taofuuu/air-PIN-gesture-lock/hardware/measurements/gy521_thickness_1.5mm.jpg

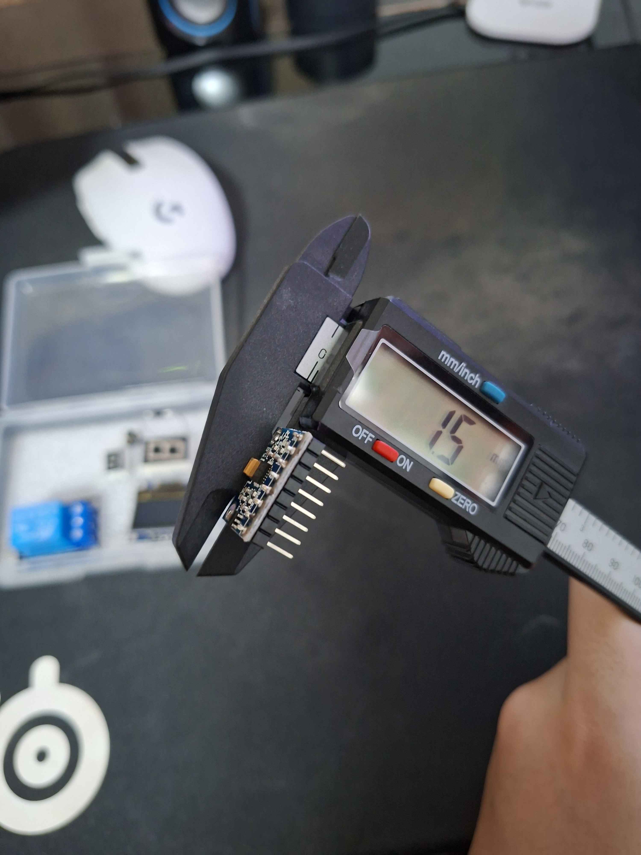
hardware/measurements/gy521_thickness_1.5mm.jpg
