taofuuu/air-PIN-gesture-lock/hardware/measurements/gy521_board-top-to-pin-tips_11.1mm.jpg

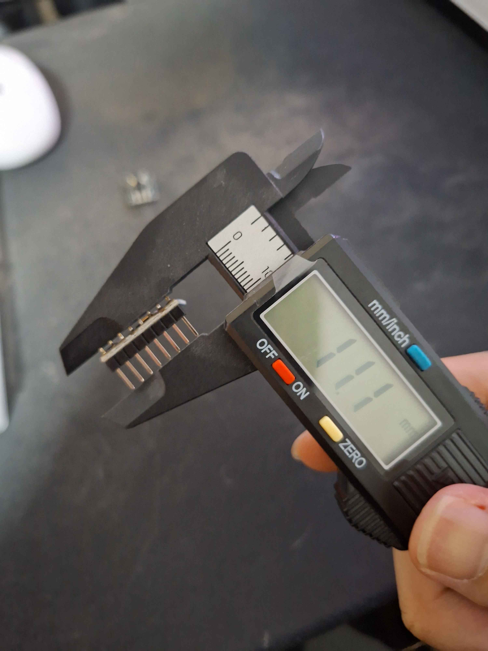
hardware/measurements/gy521_board-top-to-pin-tips_11.1mm.jpg
