taofuuu/air-PIN-gesture-lock/STRUCTURE.md

# Repo structure

Three people, three parts. Each part builds and tests on its own and talks to the others
only through the interfaces at the bottom of this file. Change an interface only after
all three agree.

| Part | Owner |
|---|---|
| ML gesture model | taofuuu |
| PIN mapping | 1999-Chin |
| ESP32 + web IoT dashboard | pedigree-pp |

## Layout

```
air-PIN-gesture-lock/
├── README.md                 overview, wiring, how to build and flash
├── STRUCTURE.md              this file
├── GLOSSARY.md               the words we use for the domain
├── CLAUDE.md                 where AI agents find the issue tracker and these docs
├── docs/adr/                 decisions that are hard to undo, and why
├── docs/agents/              issue tracker, triage labels and domain docs for AI agents
├── hardware/
│   ├── wand.scad             3D-printed wand handle
│   ├── stl/                  print-ready parts: wand_* from wand.scad, nucleo_* from CAD
│   ├── measurements/         photos of the module sizes the wand is fitted to
│   └── wiring.svg            how the sensor and button connect to the Nucleo
├── firmware/
│   ├── stm32/                STM32CubeIDE project, NUCLEO-F411RE          shared
│   │   ├── *.ioc             CubeMX pins and peripherals                 shared
│   │   ├── test/             gesture.c on a PC, with a fake network      ML
│   │   └── Core/
│   │       ├── AI/           network code generated from ml/model/       ML
│   │       ├── Inc/          one header per module = the interfaces below
│   │       └── Src/
│   │           ├── main.c    init, button, relay, calls the modules      shared
│   │           ├── imu.c     MPU-6050 driver                             shared
│   │           ├── button.c  KY-004: hold = gesture, double tap = clear  shared
│   │           ├── gesture.c runs the trained model on a recording       ML
│   │           ├── pin.c     gesture sequence -> PIN check               PIN mapping
│   │           ├── link.c    UART messages to and from the ESP32         ESP32
│   │           └── tool_*.c  bench firmware, one per build configuration (tool.h)
│   └── esp32/                ESP32 project: Wi-Fi, web server            ESP32
│       └── data/             dashboard HTML/CSS/JS served by the ESP32   ESP32
└── ml/                       training on the PC                          ML
    ├── collect.py            records labelled gestures from the Nucleo's USB serial
    ├── dataset.py            loads ml/data/ as raw recordings for training
    ├── test_pipeline.py      python -m unittest discover ml
    ├── requirements.txt      pip install -r ml/requirements.txt
    ├── train.py              trains, evaluates and exports the model
    ├── data/                 one folder per gesture, one CSV per recording;
    │                         folders starting with _ are for evaluation only
    └── model/                exported model that gesture.c is generated from
```

The model runs on the STM32 because the sensor is wired there. Code generated from
`ml/model/` (X-CUBE-AI) goes into `firmware/stm32/Core/AI/` and is
regenerated, never edited by hand.

## Interfaces

**1. IMU to ML** (`imu.h`)

```c
typedef struct { int16_t ax, ay, az, gx, gy, gz; } imu_sample_t;  // raw MPU-6050 counts
```

Sample rate and full-scale ranges are fixed in `imu.c`. Training data must be recorded with
the same settings, so changing them means re-recording.

**2. ML to PIN mapping** (`gesture.h`)

```c
typedef enum { GESTURE_UP, GESTURE_DOWN, GESTURE_LEFT, GESTURE_RIGHT, GESTURE_COUNT } gesture_t;
int gesture_classify(const imu_sample_t *samples, size_t n);  // gesture_t, or -1 if unsure
```

One button hold = one gesture: recording starts when the button is pressed and stops when it
is released. That saves the model from having to find where one gesture ends and the next begins.

A gesture ID is a plain int: PIN mapping and the dashboard store and compare it, and never assume
how many gestures there are or which ID is which. `-1` means unsure and every caller handles it.
These two rules let the model be swapped without touching the other parts
([ADR 0001](docs/adr/0001-classifier-first-embedding-later.md)).

**3. PIN mapping to main** (`pin.h`)

```c
typedef enum { PIN_INCOMPLETE, PIN_OK, PIN_WRONG } pin_result_t;
void pin_reset(void);
pin_result_t pin_add(int gesture);  // main energises the relay on PIN_OK
```

A `-1` from `gesture_classify()` is never stored in a PIN and never fills a slot; on entry it is
neither a digit nor a wrong digit, and the user is asked to repeat
([ADR 0002](docs/adr/0002-unsure-gestures-are-never-pin-input.md)).

**4. STM32 to ESP32** (`link.h`, UART 115200 8N1, one text line per message)

```
STM32 -> ESP32:  GESTURE <id>    UNLOCK OK    UNLOCK FAIL
ESP32 -> STM32:  OPEN            (remote unlock from the dashboard)
```

USART2 is the ST-LINK USB serial and stays free for `ml/collect.py` and debug prints, so the
ESP32 uses another UART. Both boards are 3.3 V logic; connect TX to RX, RX to TX and GND.

## Working rules

- Work on a short branch from `main`, named after the change, and merge it through a pull
  request. Delete the branch once it is merged.
- Everything lives on `main`. Firmware for testing one part on its own is a `tool_*.c` file with
  its own build configuration (see `tool.h`), never a branch: Debug and Release build the lock,
  Collect feeds `ml/collect.py`, GestureTest times the model, HwTest opens the relay on a click.
- Edit only your own files. Shared files (`main.c`, `imu.c`, `*.ioc`, headers in `Inc/`)
  change in small PRs that the others review.
- In CubeMX-generated files, write code only between `/* USER CODE BEGIN */` and
  `/* USER CODE END */`; regenerating wipes everything else.
- Test without the others:
  - ML: train and evaluate on the PC from `ml/data/`.
  - Firmware logic: `firmware/stm32/test/*.c` run on a PC with gcc; the command is at the top
    of each file.
  - PIN mapping: feed `pin_add()` fake gesture ids.
  - ESP32: type the line protocol into a USB-serial terminal instead of a real STM32.
