taofuuu/air-PIN-gesture-lock/hardware/stl/nucleo_f411re_wand_main_box.stl

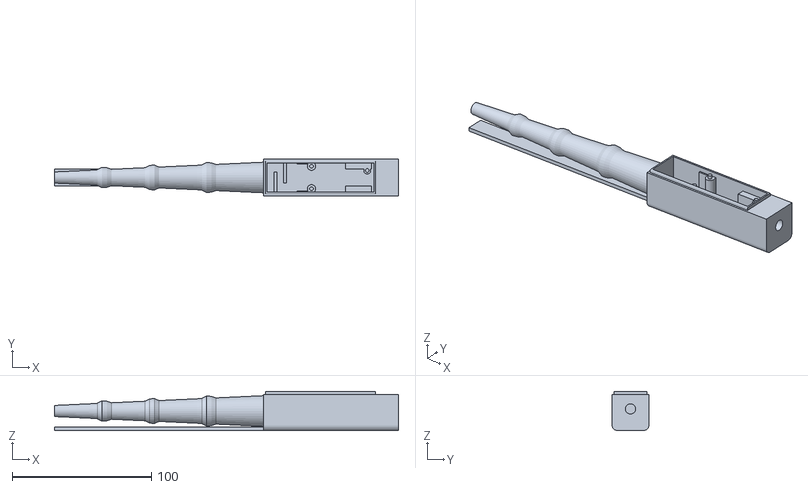
[picture p3: CAD file, 2026-11-12]
hardware/stl/nucleo_f411re_wand_main_box.stl
246.7 x 26.6 x 28.0
