taofuuu/air-PIN-gesture-lock/hardware/stl/nucleo_f411re_holder.stl

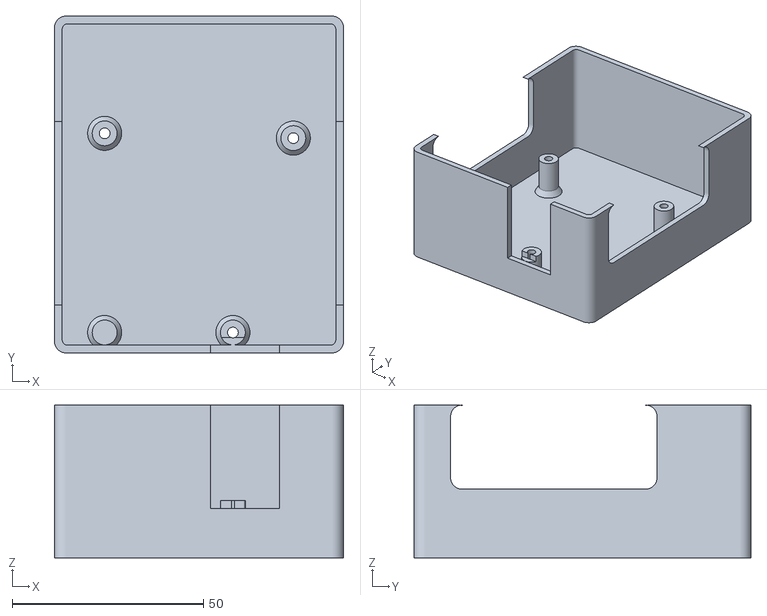
[picture p4: CAD file, 2026-11-12]
hardware/stl/nucleo_f411re_holder.stl
75.6 x 88.1 x 40.0
