taofuuu/air-PIN-gesture-lock/hardware/stl/wand_base.stl

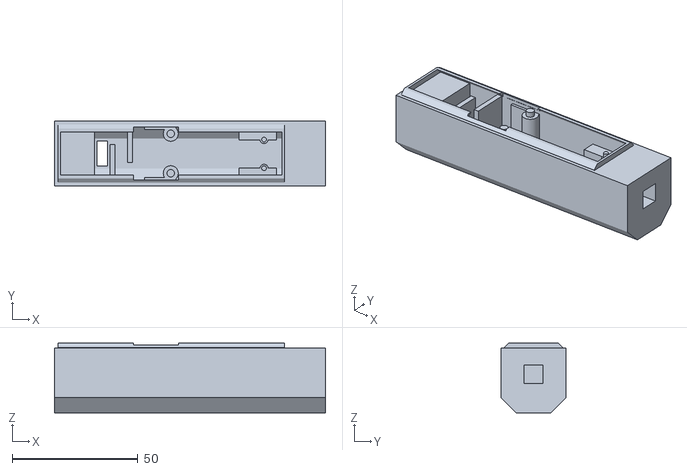
[picture p5: CAD file, 2026-10-31]
hardware/stl/wand_base.stl
107.8 x 26.0 x 27.7
