taofuuu/air-PIN-gesture-lock/hardware/stl/wand_plate.stl

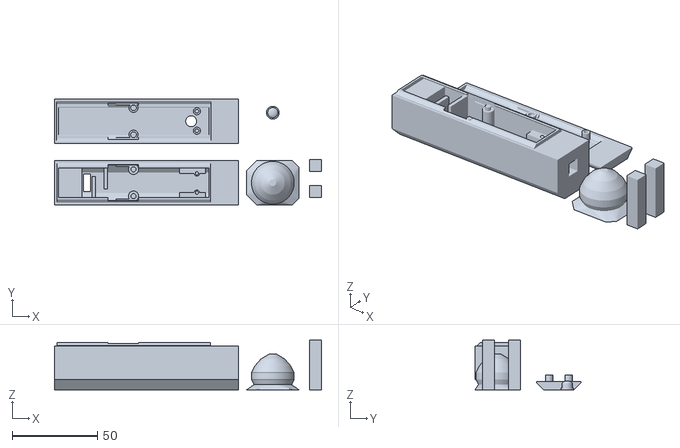
[picture p6: CAD file, 2026-10-31]
hardware/stl/wand_plate.stl
156.3 x 62.0 x 29.0
