taofuuu/air-PIN-gesture-lock/hardware/stl/wand_lid.stl

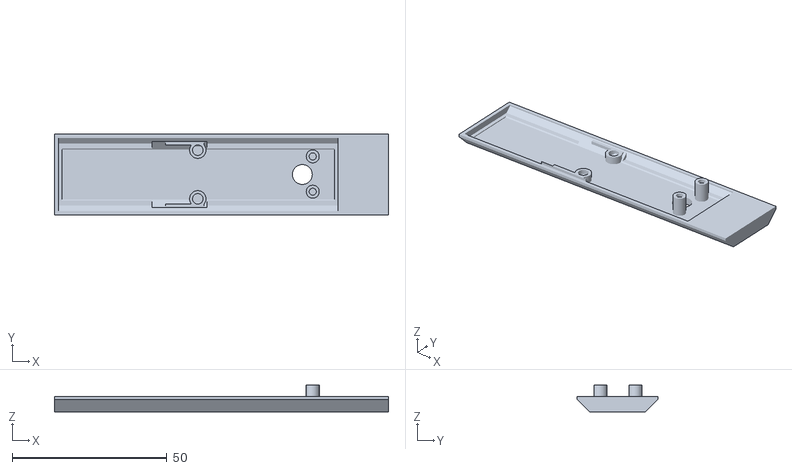
[picture p7: CAD file, 2026-10-31]
hardware/stl/wand_lid.stl
107.8 x 26.0 x 8.65
