taofuuu/air-PIN-gesture-lock/hardware/stl/wand_shaft.stl

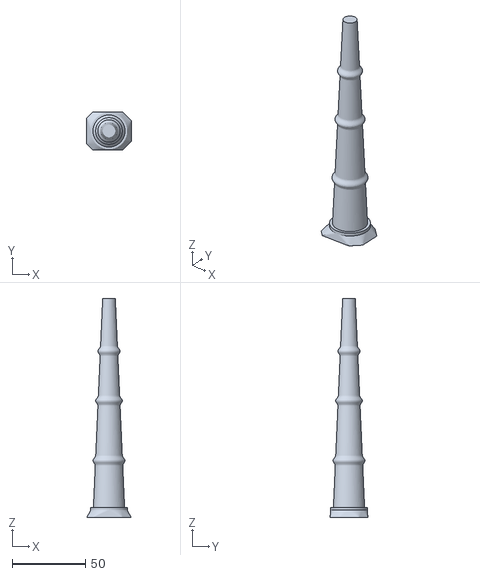
[picture p8: CAD file, 2026-10-30]
hardware/stl/wand_shaft.stl
30.6 x 26.0 x 150.0
