taofuuu/air-PIN-gesture-lock/hardware/stl/wand_cap.stl

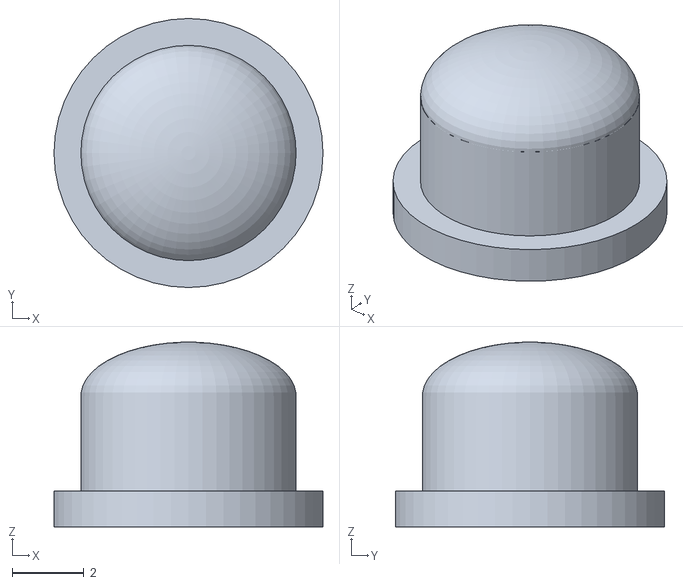
[picture p9: CAD file, 2026-10-30]
hardware/stl/wand_cap.stl
7.50 x 7.50 x 5.15
