taofuuu/air-PIN-gesture-lock/hardware/stl/wand_pommel.stl

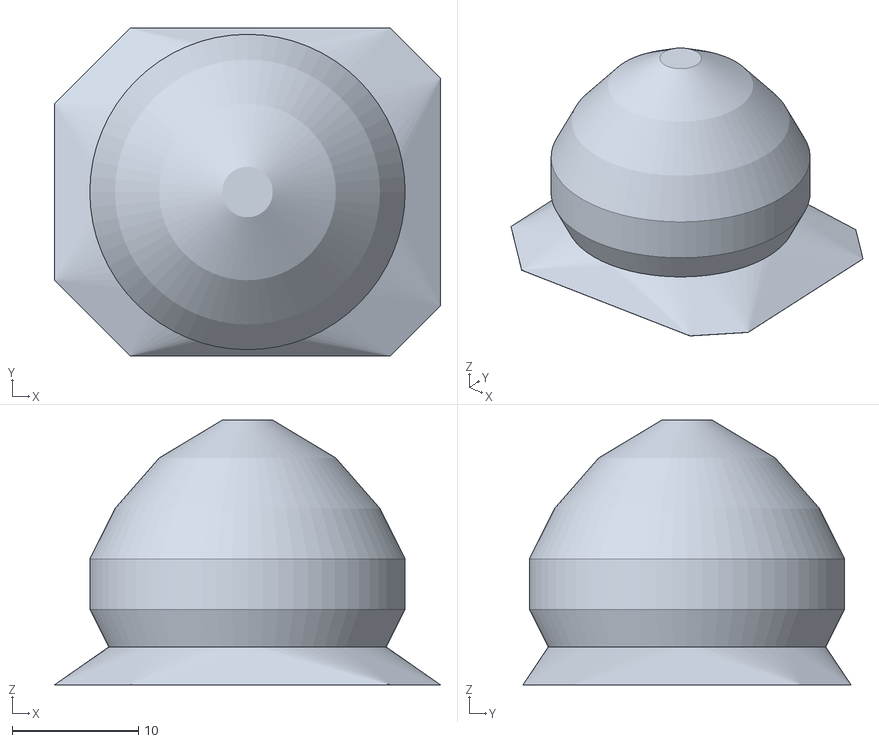
[picture p10: CAD file, 2026-10-30]
hardware/stl/wand_pommel.stl
30.6 x 26.0 x 21.0
