taofuuu/air-PIN-gesture-lock/hardware/stl/wand_pin.stl

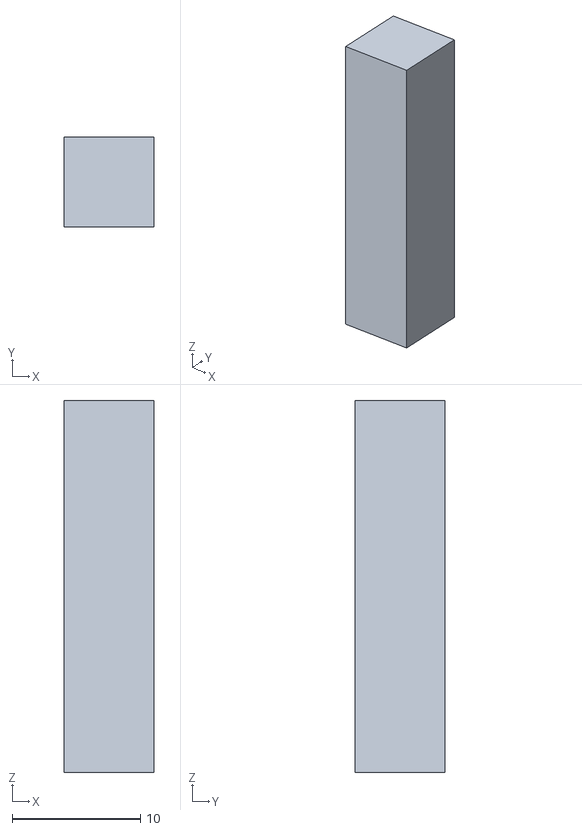
[picture p11: CAD file, 2026-10-30]
hardware/stl/wand_pin.stl
7.00 x 7.00 x 29.0
