taofuuu/air-PIN-gesture-lock/hardware/measurements/ky004_solder-bumps-to-plunger-tip_7.8mm.jpg

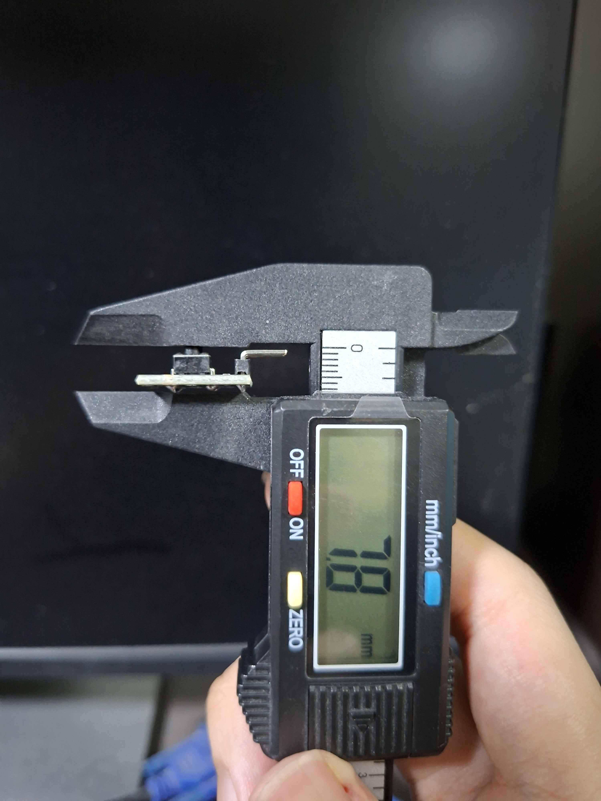
hardware/measurements/ky004_solder-bumps-to-plunger-tip_7.8mm.jpg
