taofuuu/air-PIN-gesture-lock/hardware/measurements/gy521_board-top-to-header-strip-bottom_3.8mm.jpg

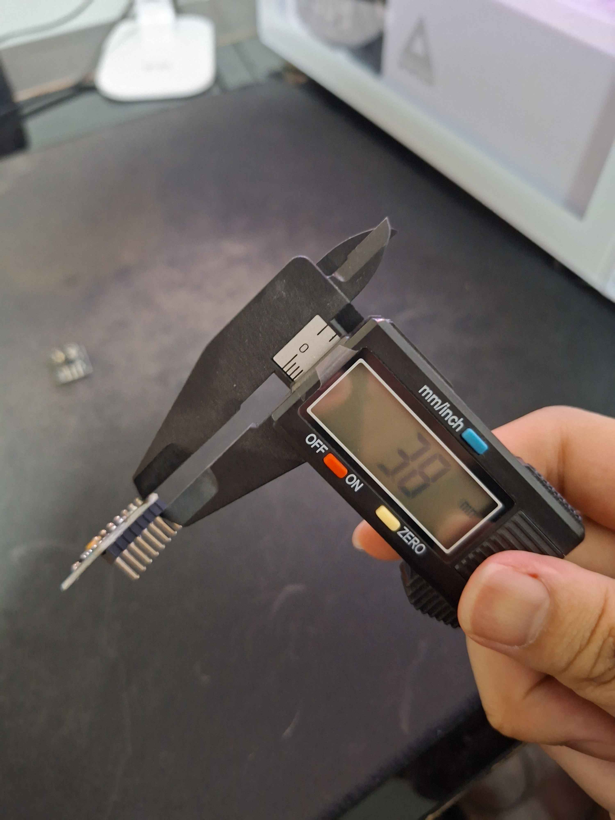
hardware/measurements/gy521_board-top-to-header-strip-bottom_3.8mm.jpg
