taofuuu/air-PIN-gesture-lock/hardware/measurements/gy521_hole-diameter_3.3mm.jpg

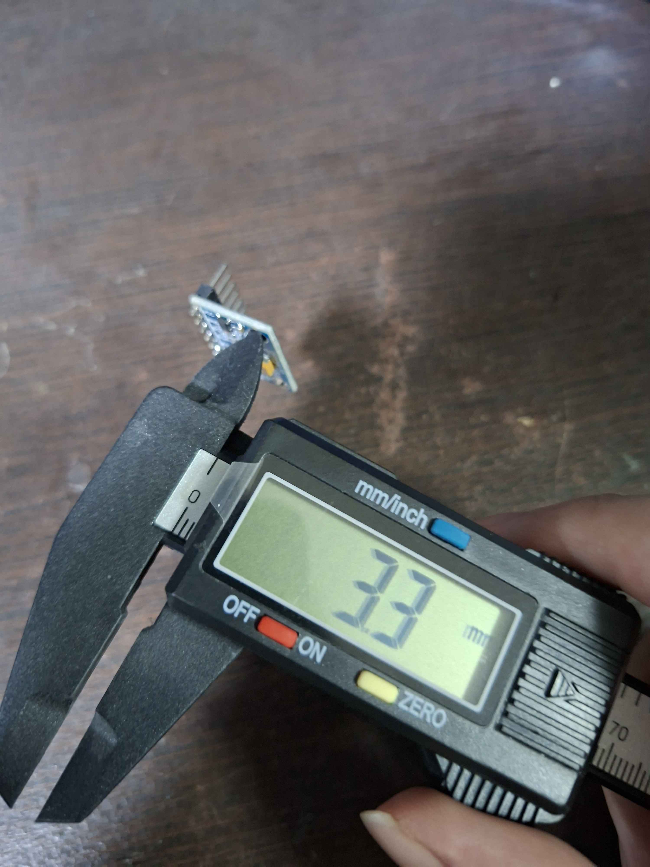
hardware/measurements/gy521_hole-diameter_3.3mm.jpg
