taofuuu/air-PIN-gesture-lock/hardware/measurements/gy521_hole-gap-front-edge_0.4mm.jpg

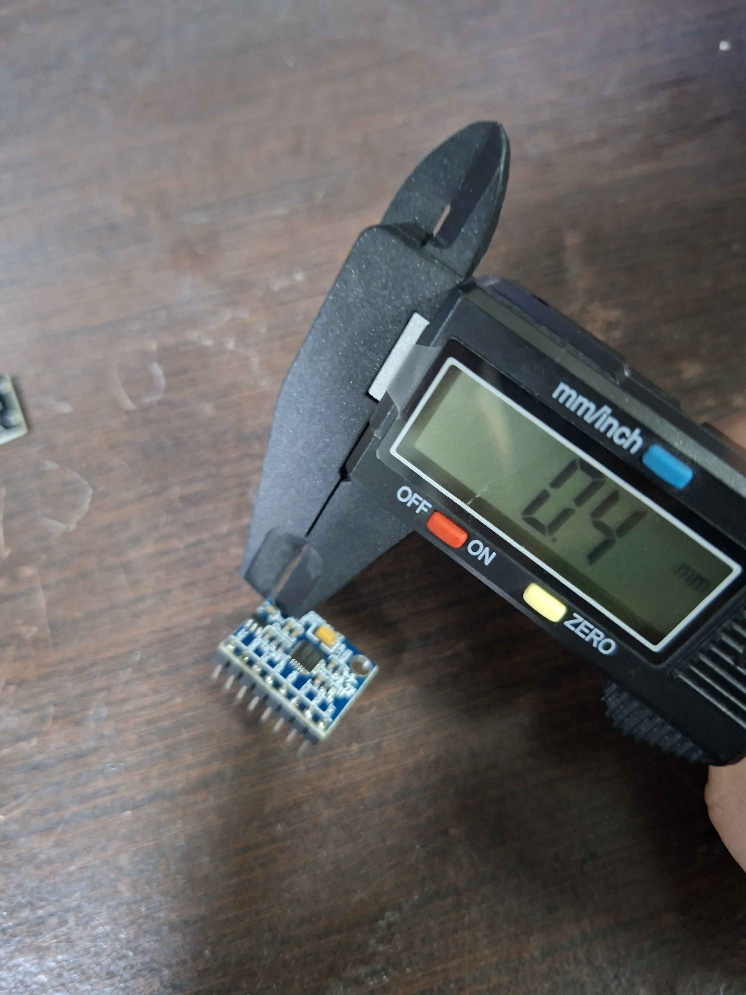
hardware/measurements/gy521_hole-gap-front-edge_0.4mm.jpg
