taofuuu/air-PIN-gesture-lock/hardware/measurements/gy521_hole-gap-side-edge_0.8mm.jpg

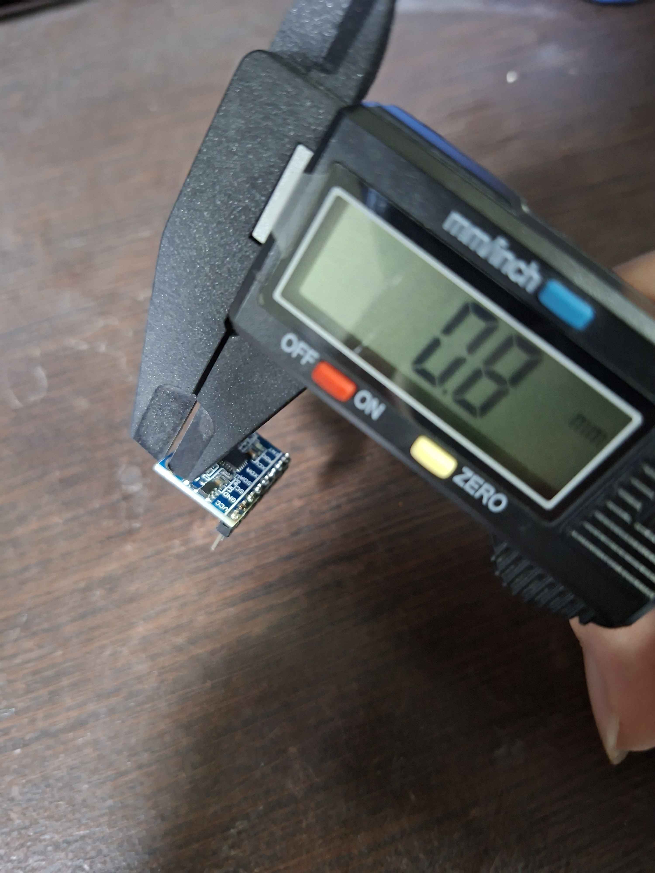
hardware/measurements/gy521_hole-gap-side-edge_0.8mm.jpg
