taofuuu/air-PIN-gesture-lock/hardware/measurements/gy521_holes-inner-edge-spacing_12.4mm.jpg

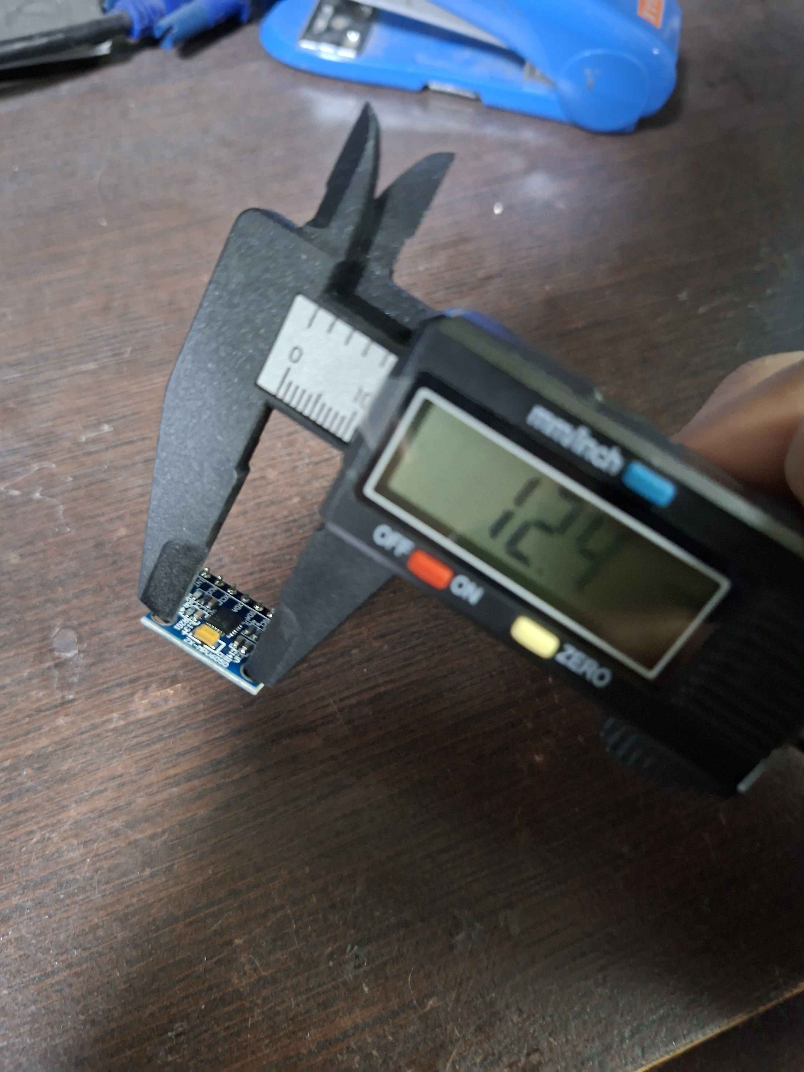
hardware/measurements/gy521_holes-inner-edge-spacing_12.4mm.jpg
