taofuuu/air-PIN-gesture-lock/hardware/measurements/gy521_length-header-edge_20.6mm.jpg

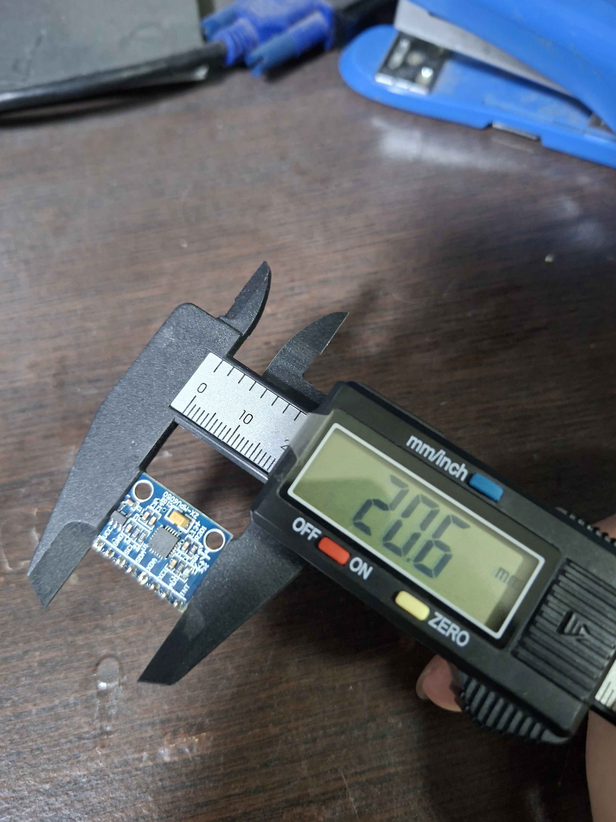
hardware/measurements/gy521_length-header-edge_20.6mm.jpg
