taofuuu/air-PIN-gesture-lock/hardware/measurements/gy521_width_15.9mm.jpg

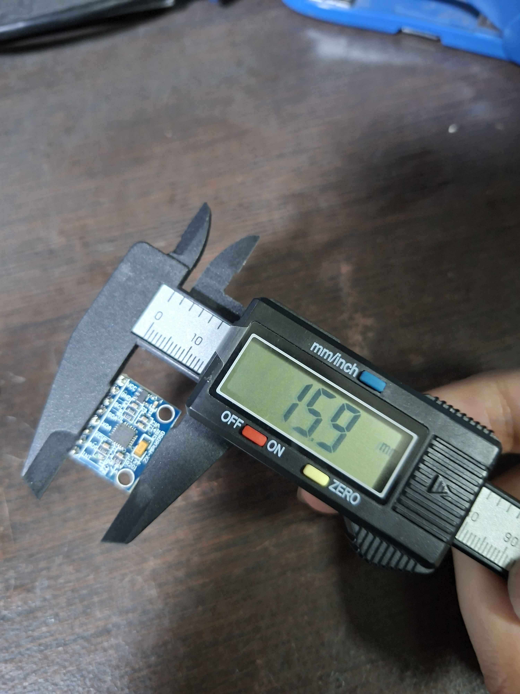
hardware/measurements/gy521_width_15.9mm.jpg
