taofuuu/air-PIN-gesture-lock/hardware/measurements/ky004_length_18.1mm.jpg

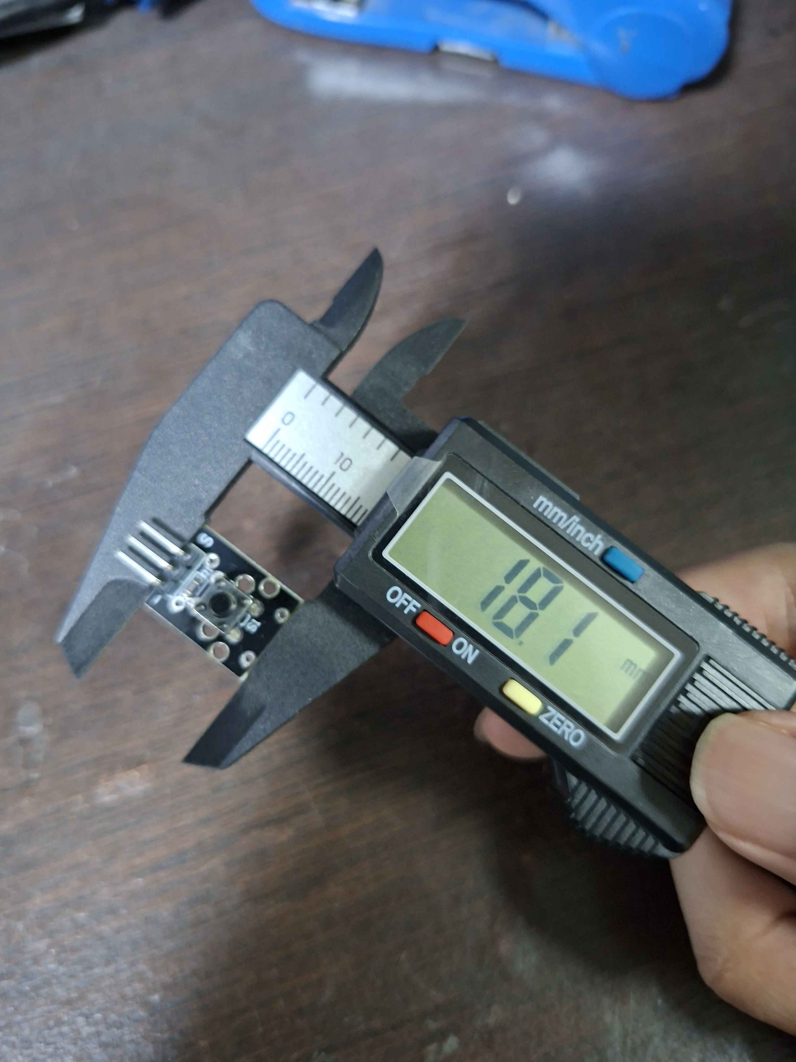
hardware/measurements/ky004_length_18.1mm.jpg
