taofuuu/air-PIN-gesture-lock/hardware/measurements/ky004_outer-hole-diameter_2.2mm.jpg

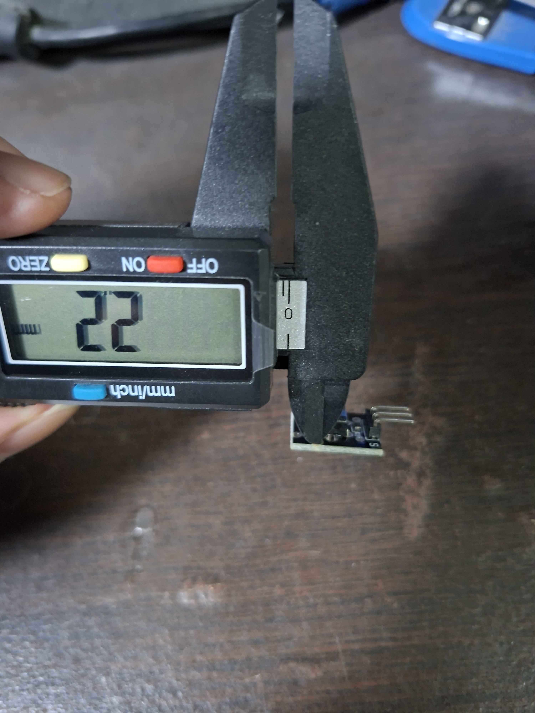
hardware/measurements/ky004_outer-hole-diameter_2.2mm.jpg
