taofuuu/air-PIN-gesture-lock/hardware/measurements/ky004_outer-hole-gap-far-edge_3.7mm.jpg

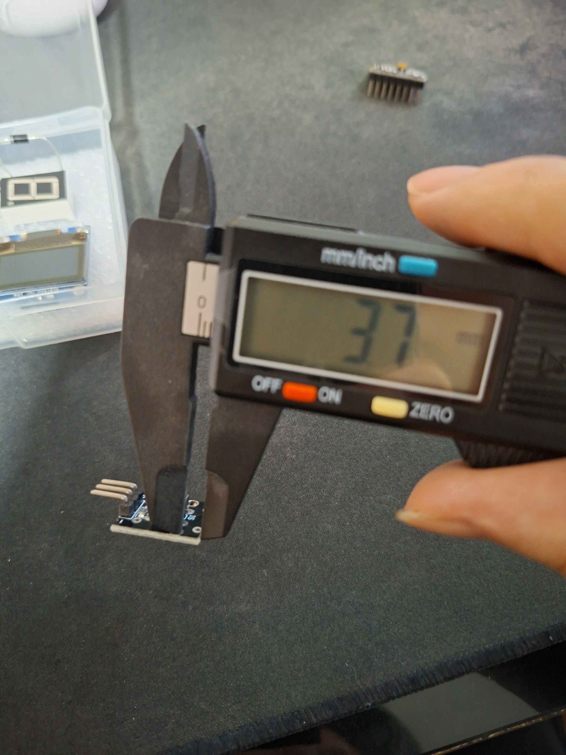
hardware/measurements/ky004_outer-hole-gap-far-edge_3.7mm.jpg
