taofuuu/air-PIN-gesture-lock/hardware/measurements/ky004_outer-hole-gap-near-side_0.1mm.jpg

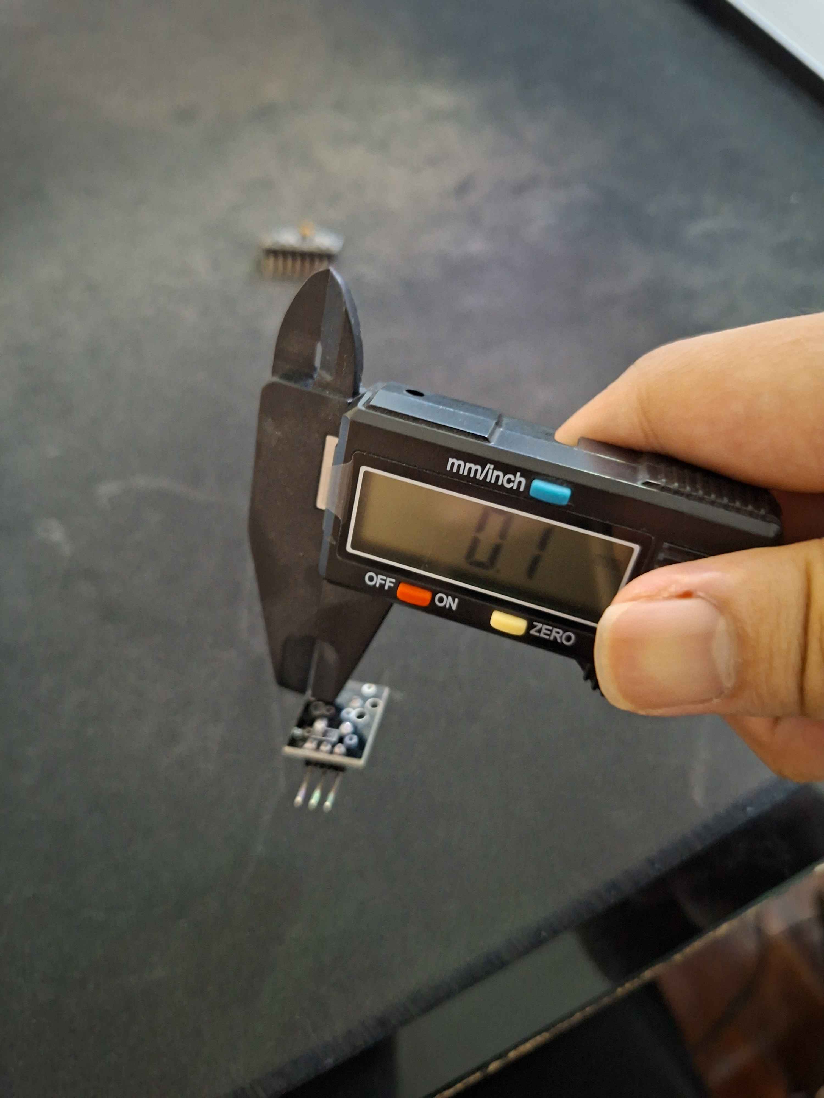
hardware/measurements/ky004_outer-hole-gap-near-side_0.1mm.jpg
