taofuuu/air-PIN-gesture-lock/hardware/measurements/ky004_outer-hole-gap-opposite-side_11.5mm.jpg

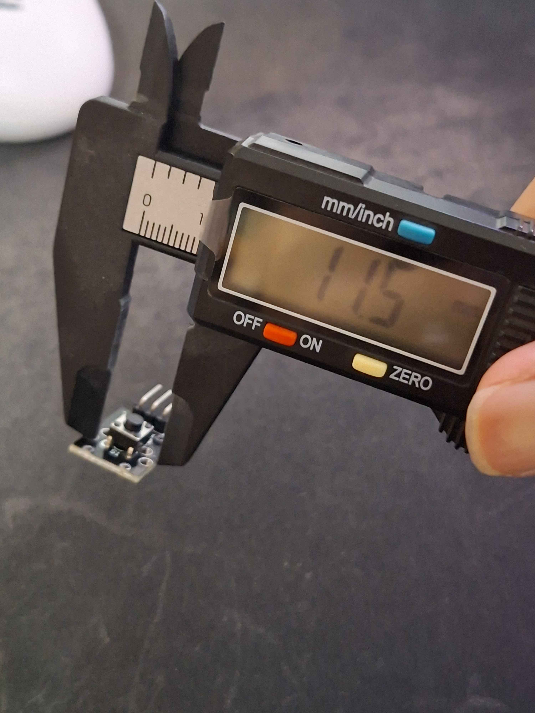
hardware/measurements/ky004_outer-hole-gap-opposite-side_11.5mm.jpg
