taofuuu/air-PIN-gesture-lock/hardware/measurements/ky004_outer-hole-gap-pin-edge_11.7mm.jpg

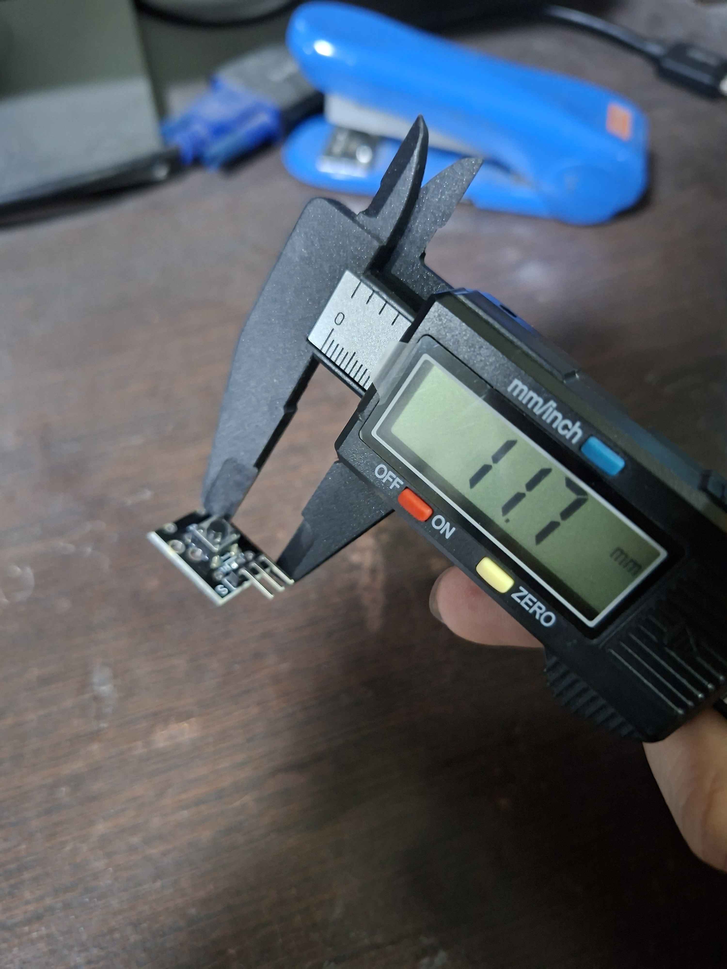
hardware/measurements/ky004_outer-hole-gap-pin-edge_11.7mm.jpg
