taofuuu/air-PIN-gesture-lock/hardware/measurements/ky004_outer-holes-inner-edge-spacing_8.9mm.jpg

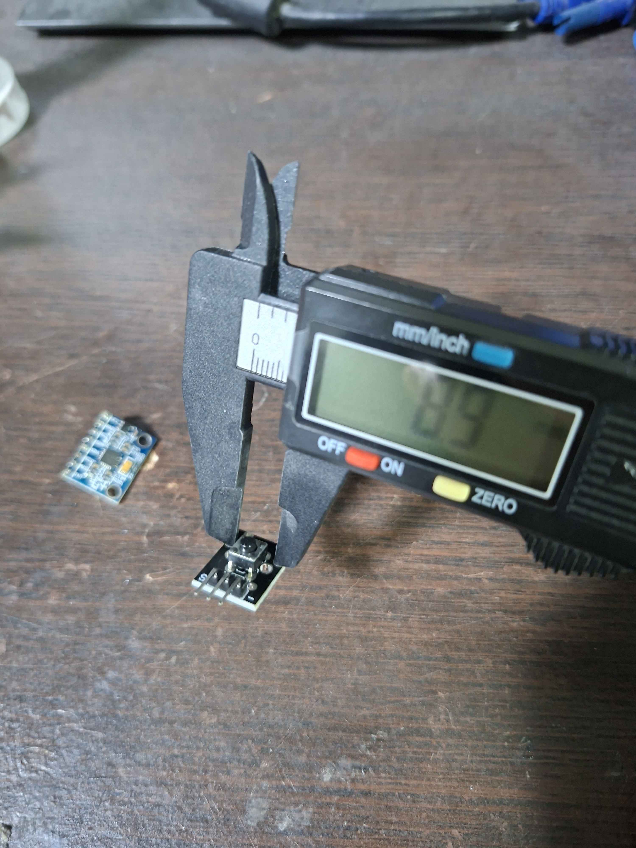
hardware/measurements/ky004_outer-holes-inner-edge-spacing_8.9mm.jpg
