taofuuu/air-PIN-gesture-lock/hardware/measurements/ky004_pin-bend-to-tip_7.5mm.jpg

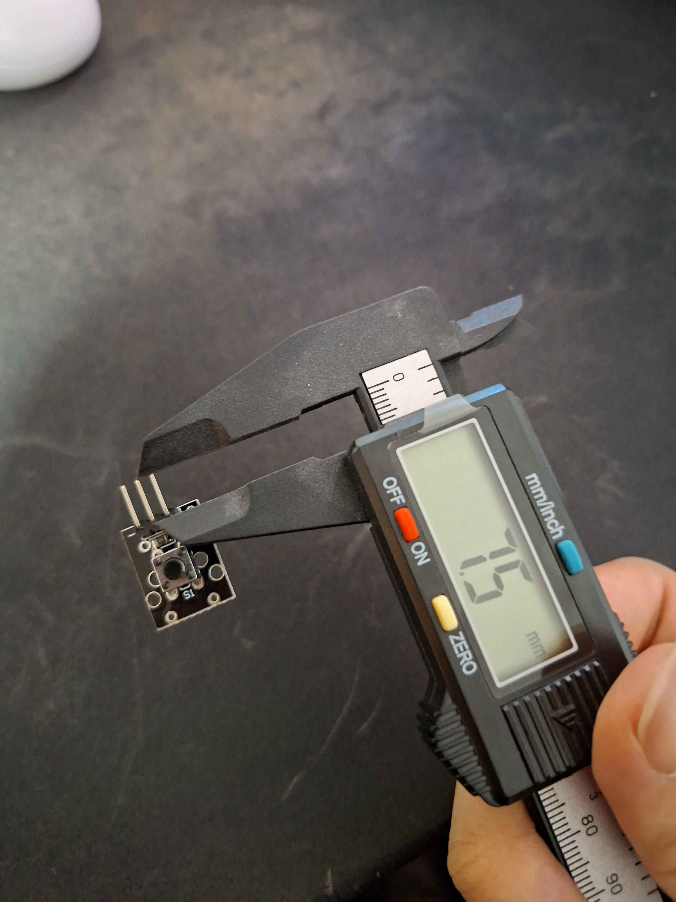
hardware/measurements/ky004_pin-bend-to-tip_7.5mm.jpg
