taofuuu/air-PIN-gesture-lock/hardware/measurements/ky004_plunger-diameter_3.1mm.jpg

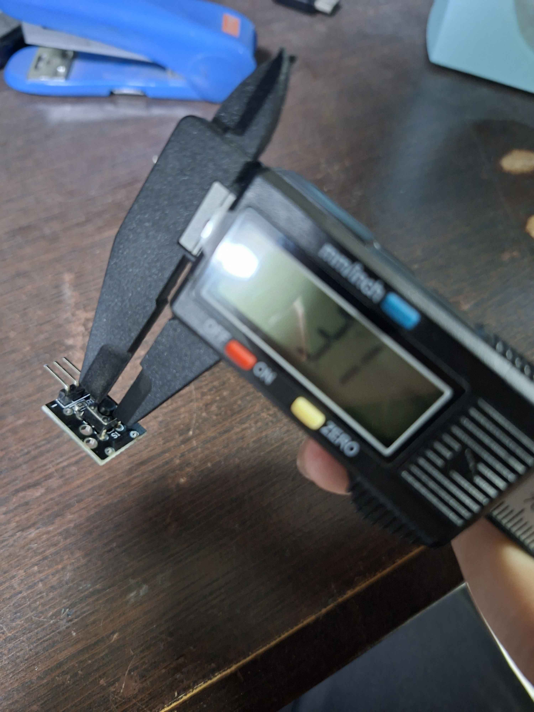
hardware/measurements/ky004_plunger-diameter_3.1mm.jpg
