taofuuu/air-PIN-gesture-lock/hardware/measurements/ky004_switch-body-side-a_5.7mm.jpg

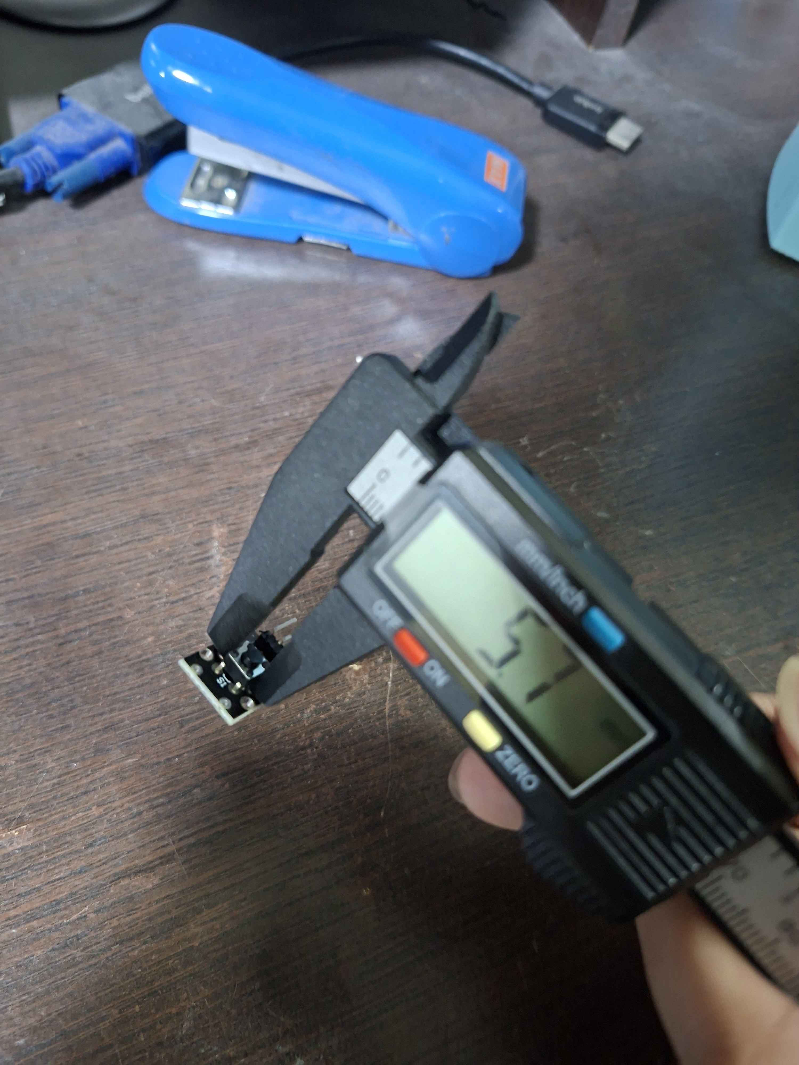
hardware/measurements/ky004_switch-body-side-a_5.7mm.jpg
