taofuuu/air-PIN-gesture-lock/hardware/measurements/ky004_switch-body-side-b_5.7mm.jpg

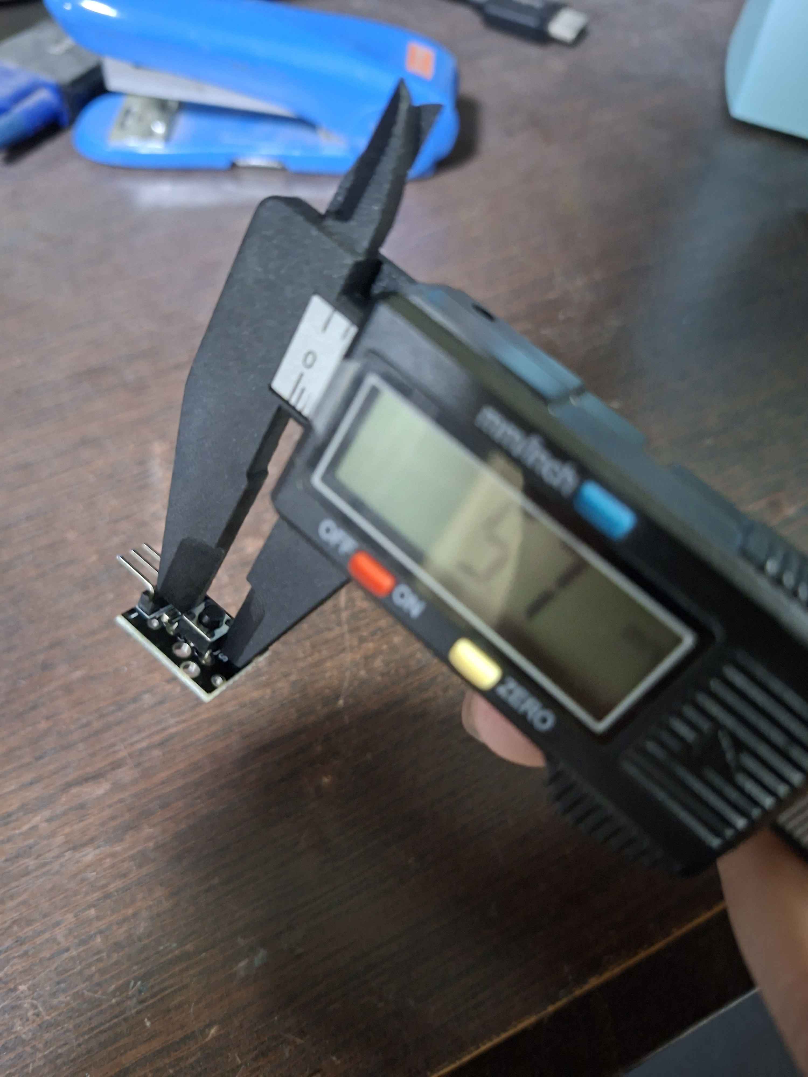
hardware/measurements/ky004_switch-body-side-b_5.7mm.jpg
