taofuuu/air-PIN-gesture-lock/hardware/measurements/ky004_thickness_1.6mm.jpg

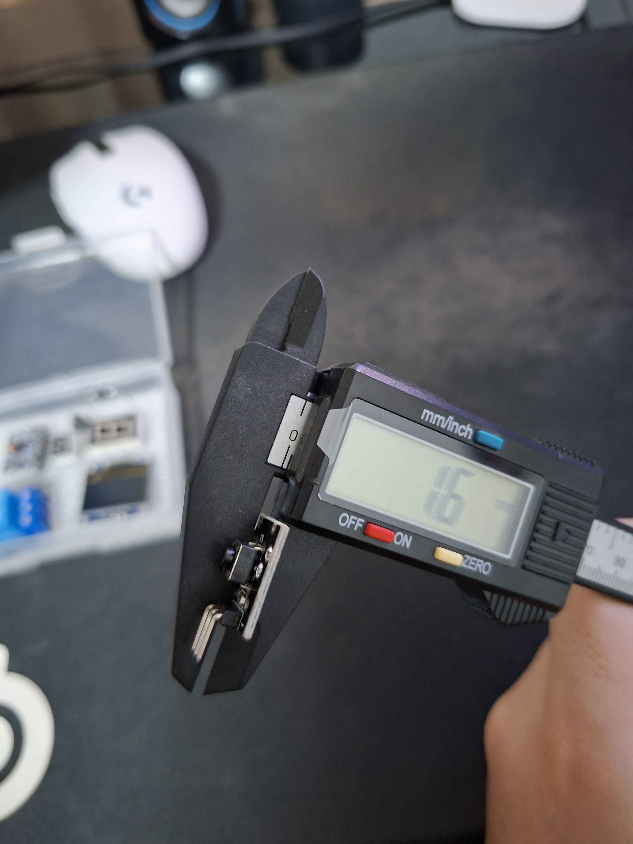
hardware/measurements/ky004_thickness_1.6mm.jpg
