taofuuu/air-PIN-gesture-lock/hardware/measurements/ky004_underside-to-bent-pin-top_5.7mm.jpg

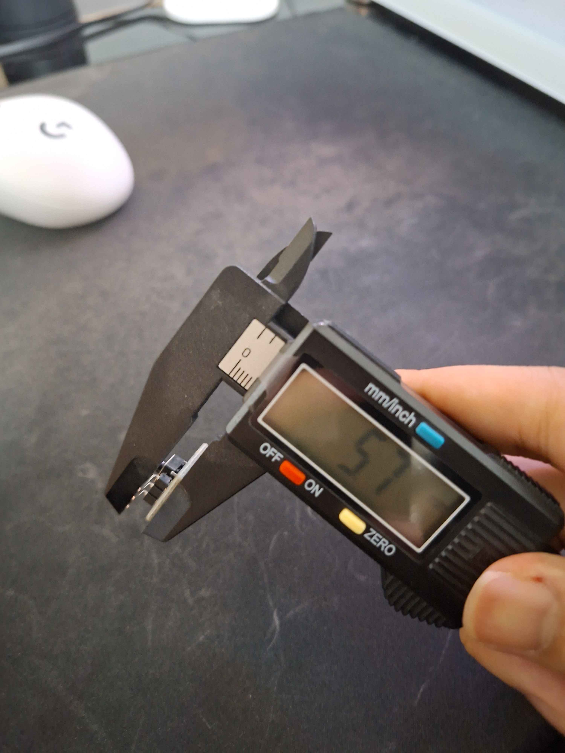
hardware/measurements/ky004_underside-to-bent-pin-top_5.7mm.jpg
