taofuuu/air-PIN-gesture-lock/hardware/measurements/ky004_underside-to-plunger-tip_6.6mm.jpg

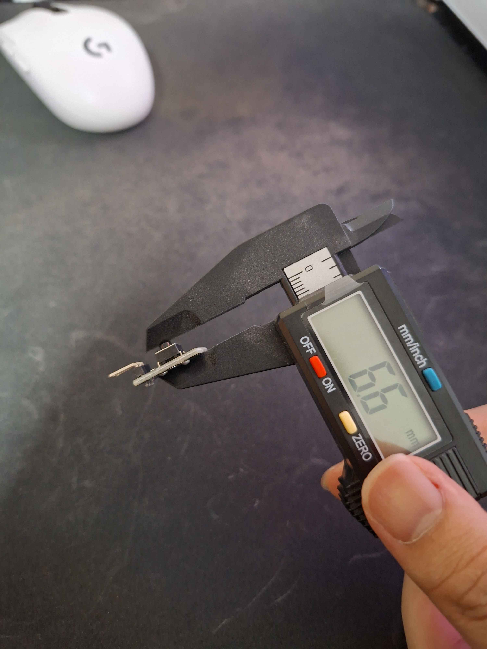
hardware/measurements/ky004_underside-to-plunger-tip_6.6mm.jpg
