taofuuu/air-PIN-gesture-lock/hardware/measurements/ky004_underside-to-switch-top_5.6mm.jpg

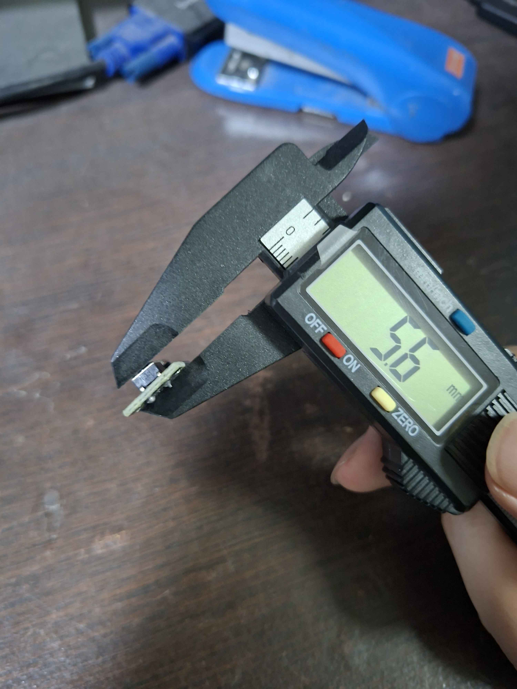
hardware/measurements/ky004_underside-to-switch-top_5.6mm.jpg
