taofuuu/air-PIN-gesture-lock/hardware/measurements/ky004_width_14.1mm.jpg

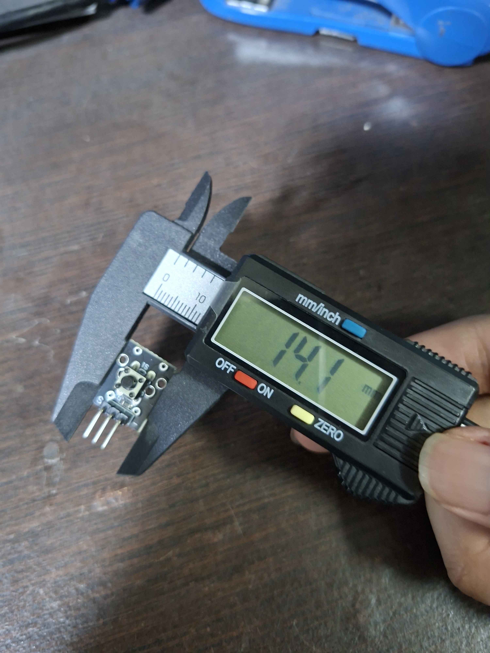
hardware/measurements/ky004_width_14.1mm.jpg
