taofuuu/air-PIN-gesture-lock/hardware/measurements/modules_top-view.webp

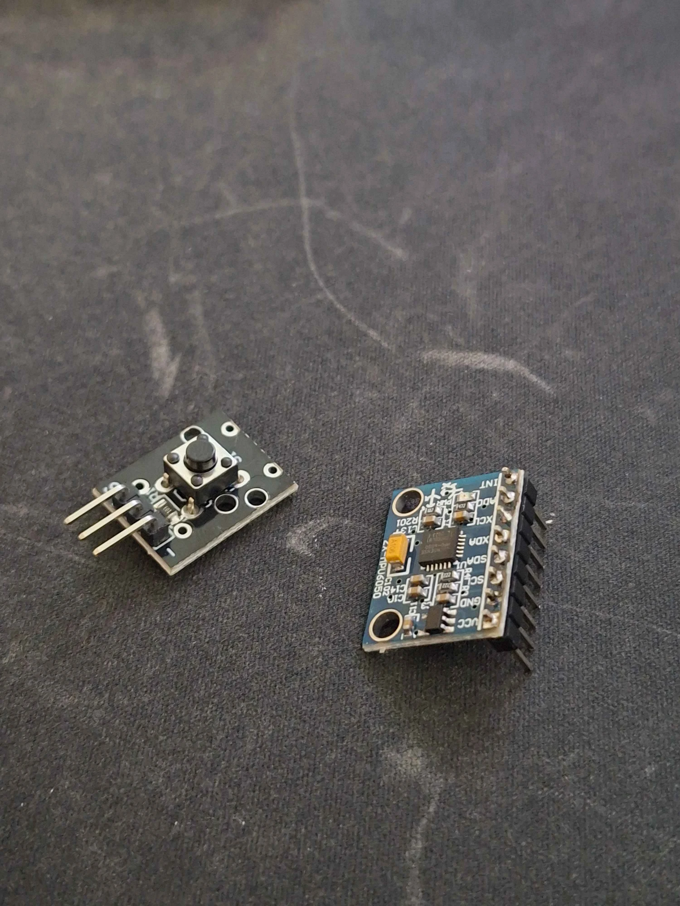
hardware/measurements/modules_top-view.webp
