taofuuu/air-PIN-gesture-lock/(commit log)

2026-10-27 Initial commit: README and STM32CubeIDE .gitignore
2026-10-27 Add 3D-printable wand handle (OpenSCAD)
    Two-part handle (base + lid) that holds the GY-521 and KY-004 on printed
    pegs and clamps them with the lid, so the borrowed modules need no solder
    or glue. All board sizes are parameters to set from measurements.
    [wand.scad]
2026-10-27 Add repo structure, team split and part interfaces
    STRUCTURE.md lays out the folders, owners and branches for the ML model,
    PIN mapping and ESP32 dashboard parts, and the interfaces between them.
    README points the STM32 project at firmware/stm32 and lists the ESP32;
    .gitignore covers ESP32 build output and Python files.
2026-10-30 Fit the wand to measured modules and add print-ready STLs
    wand.scad now uses caliper measurements of the GY-521 and KY-004 (photos
    and derivations in hardware/measurements). The button board sits on pegs
    through its outer holes, clamped by lid tubes, with a printed cap that
    presses the plunger. The teammate's decorative shaft prints separately
    and plugs into the front of the handle with a printed pin.
    hardware/stl holds every part in its print orientation.
    [wand.scad, wand_base.stl, wand_cap.stl, wand_lid.stl, wand_pin.stl, wand_plate.stl, wand_shaft.stl]
2026-10-30 Decorate the wand: faceted handle, round pommel, shaft collar
    The handle is now octagonal with 45-degree facets, so it still prints
    flat without supports. A round pommel keys onto the back and the shaft
    gets a collar that turns the handle's outline into the round shaft; both
    use square pins so the facets line up. The button cap has a domed top.
    The cable now leaves through a slot in the floor, since the back face
    holds the pommel's pin.
    [wand.scad, wand_base.stl, wand_cap.stl, wand_lid.stl, wand_pin.stl, wand_plate.stl, wand_pommel.stl, wand_shaft.stl]
2026-10-31 Let the sensor drop in and lay the wires in from above
    Two things made the printed wand impossible to assemble.
    The GY-521 could not be lowered into the base. The lip that stands above
    the seam follows the cavity's top facets, so the opening narrowed from
    21.0 mm at the board's seat to 17.0 mm at the lip's top, against a board
    20.6 mm wide; it only went in tilted. Cut the lip back to a vertical face
    over the sensor's span, which gives 21.2 mm there, and leave the rest of
    the perimeter at its full 1.0 x 2.0 mm section.
    The wires could not be threaded. The block holding the pommel's pin roofed
    the first 16 mm, so the exit slot and both baffles sat in a blind 6.6 mm
    duct with two switchbacks.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
    [wand.scad, wand_base.stl, wand_lid.stl, wand_plate.stl]
2026-11-05 Add the gesture collection tool and recording loader
    ml/collect.py records labelled gestures from the wand over the ST-LINK
    serial. It needs the data-collection mockup firmware (local branch
    ml-collect-fw), which adds the button state to each sample line; that
    line format stays private to the mockup and this tool.
    Gestures are asked in shuffled order, so tiredness and sensor drift don't
    line up with a label. A recording runs from button press to release,
    keeps the 5 samples before the press as its lead-in, and must last
    0.3-2.0 s (200 samples is also gesture.c's buffer). Each kept recording
    is saved at once in raw counts as ml/data/<gesture>/<person>_<time>.csv
    and never overwritten, so Ctr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
    [collect.py, dataset.py, test_pipeline.py]
2026-11-05 Define the gestures, the wiring and the gesture ID rules
    GLOSSARY.md fixes the words for the wand, the grip and starting pose,
    the four strokes (no return stroke), recordings and their lead-in,
    sessions, and junk and twisted recordings, so everyone records the same
    way.
    ADR 0001 (proposed) starts with a classifier and keeps embedding +
    templates for later. Gesture IDs stay plain ints and -1 means unsure, so
    the model can change without touching PIN mapping or the dashboard;
    STRUCTURE.md interface 2 carries both rules for the others to agree to.
    hardware/wiring.svg and the README table put the GY-521 on D14/D15 and
    the KY-004's S pin on D4 (PB5), both powered from 3V3. The real firmware
    nee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
2026-11-05 Add the gesture recordings
    176 strokes for training, plus _twisted/ and _junk/ for evaluation only.
    All from one person in one afternoon, so results on them say little
    about how the model does for anyone else.
    [toa_20261105-160237-377.csv, toa_20261105-160244-298.csv, toa_20261105-160305-017.csv, toa_20261105-160306-693.csv, toa_20261105-160309-593.csv, toa_20261105-160313-696.csv, toa_20261105-160314-951.csv, toa_20261105-160349-595.csv]
2026-11-05 Train the gesture classifier and export it for X-CUBE-AI
    train.py cross-validates a small 1D CNN, sets the unsure threshold and
    exports gesture_model.onnx for X-CUBE-AI, plus gesture_model.h with the
    numbers gesture.c needs around the model.
    A recording is unsure when confidence is below the threshold or when it
    fails one_movement(): confidence alone caught 12-22 of 30 junk recordings
    depending on the training seed, because the model never sees junk.
    Gravity correction uses the first 5 held samples, not the lead-in, because
    gesture_classify() only receives the hold.
    [test_pipeline.py, train.py]
2026-11-12 Pin torch below 2.9 so train.py exports opset 13
    From torch 2.9, torch.onnx.export defaults to the dynamo exporter. It
    needs onnxscript, which isn't in requirements.txt, so train.py crashed
    at export after training. With onnxscript installed it writes opset 18
    instead: converting down to 13 fails, and MaxPool/Flatten become
    Unsqueeze/ReduceMax/Squeeze/Reshape, which is not the graph X-CUBE-AI
    generated network.c from.
    torch 2.8 still uses the TorchScript exporter by default and exports
    the same opset-13 graph as the committed gesture_model.onnx.
2026-11-12 Add Chin's and Petch's gesture recordings
    40 recordings of each stroke (up, down, left, right) from each of chin
    and petch, recorded on 2026-11-12 with collect.py. Strokes only: the
    twisted and junk sets stay toa's, since train.py only evaluates on
    them.
    With three people, train.py cross-validates one person at a time:
    469/496 strokes right. 3 of petch's strokes fail the one-movement rule
    (2 down, 1 up: weakest turn 13.6 deg, lowest straightness 0.39), so
    MIN_TURN and MIN_STRAIGHTNESS may need another look.
    [chin_20261112-092928-349.csv, chin_20261112-092931-263.csv, chin_20261112-092933-450.csv, chin_20261112-092945-952.csv, chin_20261112-092950-670.csv, chin_20261112-092953-281.csv, chin_20261112-092956-171.csv, chin_20261112-092959-093.csv]
2026-11-12 Accept ADR 0002: unsure gestures are never PIN input
    Says what ADR 0001's "every caller handles -1" means for pin.c and main.c:
    never stored in a PIN, never a wrong digit on entry, a run of five is a
    fault the user clears with two quick taps, and an idle entry clears itself.
2026-11-12 Add STM32CubeIDE project skeleton for NUCLEO-F411RE
    Generated with CubeMX 6.15.0 for the STM32CubeIDE toolchain, before any
    application code, so the MPU-6050 work that follows on this branch is
    reviewable separately from generated boilerplate. Only the needed HAL
    files are copied into Drivers/ so teammates can build without
    regenerating.
2026-11-12 Read the MPU-6050 over I2C1 and stream raw samples on USART2
    The gesture model needs IMU data, and ml/collect.py records it from the
    ST-LINK serial port, so the firmware now reads the sensor and prints one
    CSV line per sample (ax,ay,az,gx,gy,gz in raw counts) at 115200 baud.
    - CubeMX: enable I2C1 at 100 kHz on PB8/PB9 (Arduino D15/D14), which is
    where the GY-521 plugs in on the Nucleo header.
    - imu.c/imu.h: wake the chip (it powers up asleep) and fix the settings
    at 100 Hz, ~44 Hz low-pass, +-4 g and +-500 deg/s. The chip's defaults
    (+-2 g, +-250 deg/s) clip during a wand swing. Training data depends on
    these values, so changing them means re-recording.
    - main.c: retarget printf to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
    [LabFinalProject.ioc, imu.c, imu.h, main.c]
2026-11-12 Recover a stuck I2C bus in imu_init()
    A chip reset during a sensor read leaves the MPU-6050 waiting to send
    the rest of its byte. A 0 bit holds SDA low, I2C1 reports BUSY, and
    every transfer fails until the power is cycled, so imu_read() fails
    silently. imu_init() now finishes the interrupted read by hand before
    its first transfer.
    - Clock 9 times with SDA released on every boot instead of checking SDA
    first. A high SDA can be a 1 bit mid-read, and the sensor keeps
    transmitting through a START. Only a missing ACK ends a read.
    - Run two rounds of 9 clocks and a STOP. A STOP fails if its own clock
    lands on the sensor's ACK to a write. ACK slots are 9 clocks apart and
    the rounds are 10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
    [imu.c]
2026-11-12 Catch failed MPU-6050 setup and recover the I2C bus at runtime
    Addresses the PR 8 review.
    A lost register write in imu_init() left that setting at its power-up
    default (e.g. +-2 g instead of +-4 g) while WHO_AM_I still read 0x68,
    so a whole session could be recorded at the wrong scale. write_reg()
    now returns the HAL status and imu_init() returns 0 on the first
    failure, as imu.h already promised for a dead sensor.
    The bus recovery only ran at boot, so a jumper popping out mid-session
    stalled the stream until a power cycle. After 10 failed reads in a row
    the loop re-runs imu_init() and resets the sample deadline so it does
    not burst to catch up. The "imu reset" line it prints is ignored by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
    [imu.c, imu.h, main.c]
2026-11-12 Run the gesture model on the STM32 with X-CUBE-AI
    gesture.c repeats train.py's preprocessing and one-movement rule around
    the network generated into Core/AI. The generated code and ST's runtime
    are committed so the project builds without X-CUBE-AI installed. The
    .ioc is untouched: only .cproject gains the headers and library.
    test/ runs gesture.c on a PC with a fake network.
2026-11-12 Enter gestures with the KY-004 and send the results on USART2
    The model could classify one recording, but nothing decided when a
    recording starts and ends or what happens to the answers. Holding the
    button now records one gesture, and the last four answers go to the
    laptop after every gesture so entry can be followed without a debugger.
    - .ioc: KY-004 on PB5 (D4), input with pull-up, labelled BUTTON. It
    reads low while pressed, as in the data-collection firmware.
    - button.c: a hold of 200 ms or more is a gesture; two shorter taps
    with the second pressed within 400 ms of the first release are a
    double tap. The shortest gesture in ml/data/ is held 400 ms, so a
    gesture is never mistake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
    [LabFinalProject.ioc, button.c, button.h, main.c, main.h]
2026-11-12 Retrain the gesture model on all three people's recordings
    Chin's and Petch's strokes are in ml/data now, so cross-validation holds out one person at a time
    instead of splitting at random: 469/496 right. The unsure threshold falls from 0.989 to 0.751,
    because three people's strokes make the model less certain of the ones it gets right. 493/496
    strokes still pass the one-movement rule, so MIN_TURN and MIN_STRAIGHTNESS stay as they were, which
    closes the note in train.py asking for a recheck once teammates had recorded.
    Add ml/reweight.py so retraining no longer needs the ST generator. Retraining changes the weights
    and the threshold but not the graph, so it rewrites the weights array in netw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
    [reweight.py]
2026-11-12 Point the branch table at the branches that exist
    ml-model is merged, the PIN work is on gesture-pin-entry, and esp32-dashboard has not been started.
    Also say that the two mockup firmware branches are rebased onto main and never merged, so they stop
    looking abandoned.
2026-11-12 Add the Nucleo holder and wand box STLs
    Exported from CAD (Open CASCADE); their source files are not in the repo yet.
    [nucleo_f411re_holder.stl, nucleo_f411re_wand_main_box.stl]
2026-11-12 Build the bench firmware from main and name the owners
    The collect, gesture test and relay test firmware lived on branches (ml-collect-fw,
    ml-gesture-fw, hw-test) that had to be rebased by hand and had fallen 20 commits behind.
    Each is now a tool_*.c file that one build configuration of the same project compiles in:
    Collect, GestureTest and HwTest, while Debug and Release still build the lock. main.c only
    hands over to tool_run() after the shared setup, so the pinout, drivers and imu.c exist once.
    The branch table in STRUCTURE.md pointed at branches that are gone; it now names the owners:
    Chin for PIN mapping, Petch for the ESP32 dashboard. The README says to import the existing
    CubeIDE pro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
